annak1n/RoboVacuum/schematics/README

schematics are created using gEDA 
http://www.geda-project.org/
