annak1n/RoboVacuum/schematics/wheel_encoder.png

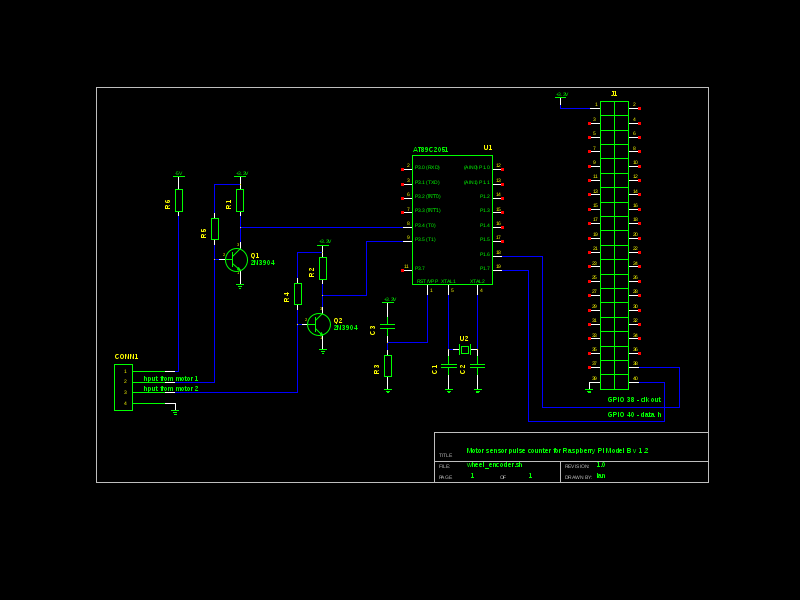
schematics/wheel_encoder.png
