annak1n/RoboVacuum/schematics/wheel_motor.png

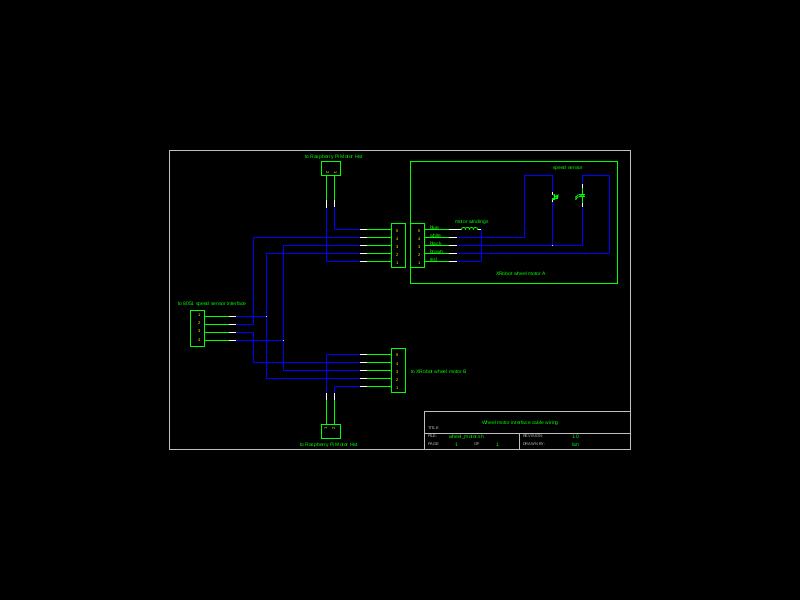
schematics/wheel_motor.png
