annak1n/RoboVacuum/src/python/vision/outfile.jpg

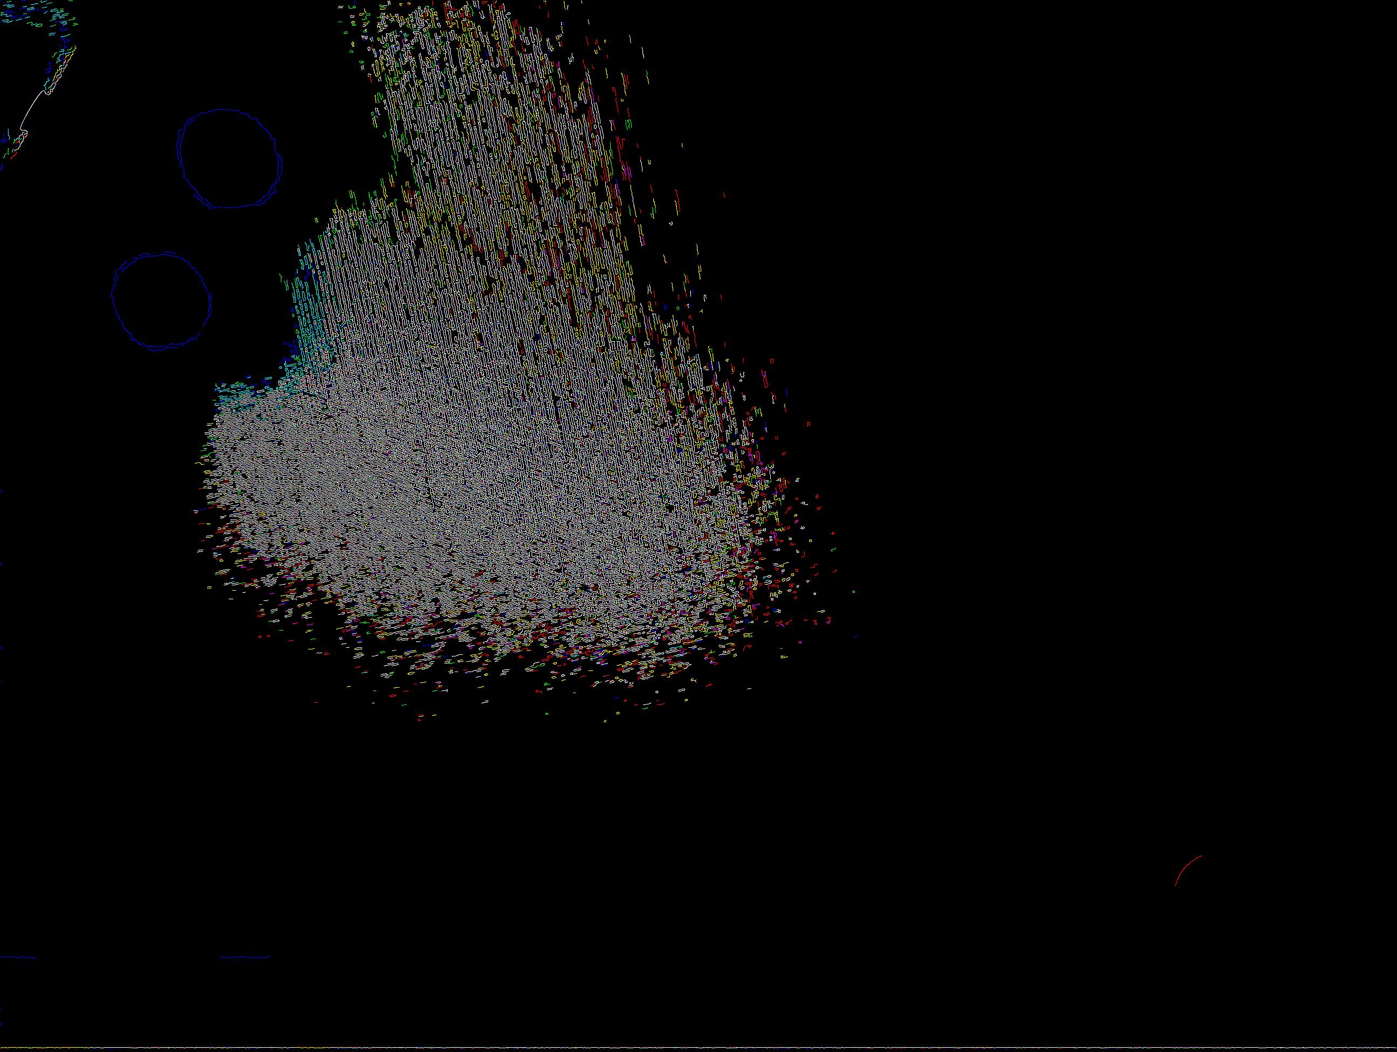
src/python/vision/outfile.jpg
