annak1n/RoboVacuum/(commit log)

2017-02-04 This version contains an adpted version of "ghirlekar"'s BNO055 python code, adding additonal calibration functions, allowing users to get and set calibration. There is also an assisted calibration f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
2017-02-04 Fixed typo in which the system calibration status was not checked...
2017-02-19 This version contains some test functions for sensors, and a remote control for testing the motors
2017-02-25 Added some test functions for calibration of motors. Next commit will move back to serial BNO due to i2c bug...
2017-02-25 This update changes the BMO055 from I2C to serial for error free signal and creates a super class to include the functions added to the origninal class
2017-03-18 Added some camera stuff
2017-03-18 added an edge detection test for camera
2017-03-18 added a fused robot class to reduce amount fo boilerplate in scripts
2017-03-18 some fixes for remote. It now wroks with the threading. PID needs work... but issue is from BNO055 clock stretch..
    [remote_control_2.py, roboMain.py]
2017-03-19 Some updates to test the camera
2017-04-01 changed motor class to have motor groups from different devices. Cleaned up BNO055 to remove clock stretching work arounds. Updated roboMain to work with new motor class
2017-04-01 fixed some indentation errors
    [motor_class.py, roboMain.py]
2017-04-01 fixed a few bugs and tested the new motor class. Working for remote_2, remote.py will ned adaption.
    [motor_class.py, random_clean.py, roboMain.py]
2017-04-05 Initial version
    Class for reading wheel motor speed from gap encoders
2017-04-05 Add initial version of 8051 code for wheel motor encoder
2017-04-05 Add initial versions of wheel encoder schematic diagrams
    [wheel_encoder.sch]
2017-04-06 add details of suggested wiring for wheel motors
    [wheel_motor.sch]
2017-05-21 added at exit protection for motor
2017-05-21 implementing motors encoders
2017-05-21 added encoder to robotclass
2017-05-21 Added new adress to ADC
2017-05-21 inverted encodes in PID loop
    [roboMain.py]
2017-05-22 Added PID to test_rotor.py to test straightline movment
2017-05-25 added micro second timing to rotor test function
2017-05-25 Added some PID stuff
2017-05-25 added pid stuff to roboclass
2017-06-03 Version updated to use matrix, has bug when handling angles in radians. Differences between angles are incorrectly wrapped around.
    [roboMain.py]
2017-06-03 fixed test rotated and anded paprisus mapping
    [roboMain.py, test_map_rotate.py]
2017-06-03 fixed angle bug. still searching for jitter bug
    [roboMain.py, test_map_rotate.py]
2017-06-03 Tuned motor pid
2017-07-21 Changed i2c adress for ADC, not sure how it became different. It seems to have changed while adding the 12v to 5v inverter.
2018-03-30 Running version with ADC i2C io changed.
2018-03-30 corrected typo (Draw not draw), using correct API call for draw function.
    [roboMain.py]
2018-03-30 flipped x and y in the display
    [roboMain.py]
2018-03-30 corrected sign error in rotation matrix calcualtion
    [roboMain.py]
2018-03-30 removed motor from test
2018-03-30 non working version with some typos fixed
    [roboMain.py]
2018-04-02 added units to the robomain and PID
    Added a simple lag filter
2018-04-02 removed some transofrmation matrixes pint doesn't like
    [roboMain.py]
2018-04-02 added some bug checks to the mc loop
    [roboMain.py]
2018-04-02 removed velocity from calc
2018-04-02 found bug where time step would increase in first itteration
    [roboMain.py]
2018-04-02 changes to PID loop
2018-04-02 more PID training
2018-04-02 Update PID
2018-04-02 Version with tuned PID for MC
2018-04-02 Silenced some prints
2018-04-02 added a print in mapping protocol
    scaled resoltion to 2.5 cm
2018-04-07 fixed a bug in the position being 0,0 intially. Fixed a bug where the rotation matrix was the wrong size.
    [roboMain.py]
2018-04-07 possible bug in dot product with rotation
    [roboMain.py]
2018-04-07 another bug caused by pint
    [roboMain.py]
2018-04-07 fixed rotation speed. Probably a stupid method.
    [roboMain.py]
2018-04-07 yet more changes to test mapping. It is possible the virtual sensor is at 90 degrees to the pyhsical one
2018-04-07 testing rotation of sensor in map
2018-04-07 fixed issue where empty cone was given 50/50 value in map
    [mapping.py]
2018-07-28 Big fixes on device
    [DWR_wheel_control.py]
2018-07-28 changed the robomain to use some of the new external functions
    added saving of wheel calibration data
2018-07-28 working version on robot,calibration completes, motor contoler class appears to work
2018-08-04 lots of bug fixes. Speciifcally encoder has an overflow bug, added a catch in the lag filter.
    [DWR_wheel_control.py, wheel_encoder.py]
2018-08-04 remote now uses the new class for motor control
2018-10-28 version of remote control which uses thenew motor classes.
2018-10-28 New remote and test functions. Identified issue where MC higs the active core which means all other ,ogic is slow
    [DWR_wheel_control.py, remote_control_3.py, test_run_untill_distance.py]
2019-02-28 added multiple ir sensors to ir class added edge detection test to vision module
